baijiazheng/JB-Micro-Wheeled_leg-Robot/docs/board_spec.md

# 板级规格书（四板统一定义）

> 定稿 2026-09-13 ｜ 修订 2026-09-14（编码器/IMU 改卫星板、补板间连接器）
>
> 全车 **4 块 PCB**：驱动板 F103 (50×50)、主控板 F407 (50×50)、编码器板 ×2 (12×12)、IMU 板 ×1 (12×12)。
> 两块大板同尺寸、同孔位 → 可堆叠 → 即插即用。

---

## 一、机械规格

### 1.1 两块大板（统一定义）

| 项 | 值 | 说明 |
|---|---|---|
| **外形尺寸** | **50 × 50 mm** | 两板统一，圆角 R2 |
| 层数 | 2 层 | 顶层信号 + 底层整片 GND |
| 板厚 | 1.6 mm | 嘉立创标准 |
| 铜厚 | 1 oz（电机轨可 2 oz） | |
| 安装孔 | **4× M2.5**，坐标 (3,3)(47,3)(3,47)(47,47) | 原点取板左下角 |
| 堆叠 | 驱动板在下、主控板在上，M2.5 铜柱 8mm | 见"五、堆叠" |

**尺寸依据**：驱动板 45 个元件封装占用 ≈ 940 mm²（其中 2× L6234 占 352 mm²），
主控板 30 个元件 ≈ 620 mm²；50×50 = 2500 mm² → 密度 38% / 25%，布线空间充裕。

### 1.2 三块卫星板

| 板 | 尺寸建议 | 元件数 | 说明 |
|---|---|---|---|
| 编码器板 ×2 | 12 × 12 mm | 6 | AS5600 正对电机轴端磁铁，**必须现场定位** |
| IMU 板 ×1 | 12 × 12 mm | 6 | 放整车重心投影点，远离电机热源 |

**三块小板的摆放位置由机械决定，所以做成卫星板。** 打样时它们和两块大板**拼在同一张 50×50
里**（V-CUT 或邮票孔），掰开即用，成本几乎为零。

---

## 二、功能分区（坐标原点 = 板左下角）

### 2.1 驱动板 F103（45 元件）

```
(0,50)                                                  (50,50)
  ┌──────────────────────────────────────────────────┐
  │ ○(3,47)                                  (47,47)○│
  │  ┌── 电源区 (x5~20, y34~47) ──┐ ┌─ 通信区 (x30~47, y34~47) ─┐
  │  │ J1 电池  SW1  D1           │ │ U9 TJA1050  R8 120Ω      │
  │  │ U7 MP2225  L1  U8 AMS1117  │ │ U10 CH340C  J5 USB  C22   │
  │  │ C1~C4  C23 C24  R1 R2 R3   │ │ J4 SWD  J7(→IMU 板)      │
  │  └────────────────────────────┘ └──────────────────────────┘
  │         ┌──── MCU 区 (x13~37, y18~32) ────┐
  │         │  U1 LQFP-48                     │
  │         │  R9 BOOT0  R10/C19 NRST  C25 去耦│
  │         │  R12/R13 电池分压 (100k/47k)     │
  │         └─────────────────────────────────┘
  │        J6(→编码器①)      J8 板间 2×4      │
  │  ┌─ 电机1 (x2~20,y2~15) ─┐  ┌─ 电机2 (x30~48,y2~15) ─┐
  │  │ U2 L6234  C5 C6       │  │ U3 L6234  C7 C8       │
  │  │ C13 C14 C15           │  │ C16 C17 C18           │
  │  │ J2 电机1 3P           │  │ J3 电机2 3P           │
  │  └───────────────────────┘  └───────────────────────┘
  │ ○(3,3)                          D2 LED  (47,3)○    │
  └──────────────────────────────────────────────────┘
(0,0)                                                  (50,0)
```

### 2.2 主控板 F407（30 元件）

```
(0,50)                                                  (50,50)
  ┌──────────────────────────────────────────────────┐
  │ ○(3,47)                                  (47,47)○│
  │  ┌── 电源区 (x5~20, y34~47) ──┐ ┌─ 通信区 (x30~47, y34~47) ─┐
  │  │ J1 电池  SW1  D1           │ │ U2 TJA1050  R4 120Ω      │
  │  │ U5 MP2225  L1  U4 AMS1117  │ │ U3 CH340C  J5 USB  C9    │
  │  │ C1~C4  C6 C7  R1 R2 R3     │ │ J4 SWD  R6 D2 LED        │
  │  └────────────────────────────┘ └──────────────────────────┘
  │         ┌──── MCU 区 (x13~37, y18~32) ────┐
  │         │  U1 LQFP-100                    │
  │         │  R7/C8 NRST  R5 BOOT0  C5 去耦  │
  │         └─────────────────────────────────┘
  │         J2 舵机总线 3P      J3 板间 2×4    │
  │ ○(3,3)                                  (47,3)○   │
  └──────────────────────────────────────────────────┘
(0,0)                                                  (50,0)
```

### 2.3 卫星板

```
编码器板 (12×12)              IMU 板 (12×12)
 ┌───────────────┐             ┌───────────────┐
 │ J2 GH1.25 4P  │             │ J1 进  J2 出  │
 │ U1 AS5600     │             │ U1 MPU6050    │
 │ R1 R2 4.7k上拉│             │ C1 C2 C3      │
 │ C1 C2         │             │               │
 └───────────────┘             └───────────────┘
  AS5600 芯片中心必须正对磁铁   两个 GH 座串联，串在编码器②线上
```

---

## 三、硬约束（违反则板子废）

| # | 约束 | 原因 |
|---|---|---|
| 1 | **AS5600 与磁铁轴向间距 0.5~3 mm，中心对齐** | 磁编码器测轴端磁场，偏了就测不准 |
| 2 | **IMU 板放整车重心投影点** | 否则平衡算法读数有系统性偏差 |
| 3 | **J6/J7/U1 的 I²C 走线短、不跨分割地** | I²C 是开漏弱上拉，干扰敏感 |
| 4 | **L6234 (U2/U3) 靠板边**，散热焊盘(EP)大铺铜 + 过孔 | 线性驱动发热 |
| 5 | **U1 每个电源脚旁 0.1uF 紧贴** | 去耦 |
| 6 | **电机轨（VIN→L6234 Vs）加粗 ≥1mm** | 电机电流 |
| 7 | **底层整片铺 GND**，不割断 | 完整地平面 |
| 8 | **MP2225 功率回路（U7/L1/C1/C3）面积最小** | 开关电源环路是 EMI 和纹波的根源 |
| 9 | **板间 J8/J3 丝印必须标脚 1** | 插反烧两板 |

---

## 四、焊接约束（锡膏 + 加热台 + 钢网）★

**加热台一次只能焊一面**（背面元件会被压住/位移），所以：

- ✅ **所有 SMD 放同一面**（统一放**顶层**）
- ✅ 插件元件（J1~J5 排针、SW1 开关、USB）放**底层**，或顶层最后手焊
- ✅ 一次回流焊完成所有 SMD → 再手焊插件

**必须买钢网**：手点锡膏焊 0.5 mm 间距（LQFP-100 / QFN-24）基本必连锡，钢网 ¥30~60。

**交给嘉立创 SMT 贴的 5 个难焊件**（路线 C）：

| 板 | 位号 | 器件 | 封装 | 难点 |
|---|---|---|---|---|
| 主控板 | U1 | STM32F407VET6 | LQFP-100 | 100 脚 / 0.5 mm |
| 驱动板 | U1 | STM32F103C8T6 | LQFP-48 | 48 脚 / 0.5 mm |
| 驱动板 | U2/U3 | L6234 | PowerSO-20 | 底部散热焊盘 |
| IMU 板 | U1 | MPU6050 | QFN-24 | 底部散热焊盘 / 0.5 mm |

其余（0805 阻容、SOT-223、SOIC-8、SOP-16、TSOT-23-8）加热台自焊。

---

## 五、堆叠（即插即用）

```
        ┌──────────────┐
        │  主控板 F407  │  ← 上层（母座 2×4）
        └──────────────┘
           ↓ ↓ ↓ ↓         2×4 排针（公头在驱动板上）
        M2.5 铜柱 ×4 (8mm)
           ↓ ↓ ↓ ↓
        ┌──────────────┐
        │  驱动板 F103  │  ← 下层（贴电机，唯一电源入口）
        └──────────────┘
```

### 板间 2×4 排针脚位定义（★ 两板必须一致）

| 脚 | 信号 | 脚 | 信号 |
|---|---|---|---|
| **1** | VIN (7.4V) | **2** | VIN |
| **3** | GND | **4** | GND |
| **5** | CAN_H | **6** | CAN_L |
| **7** | GND | **8** | GND |

**设计要点**：

- 电源 2 脚并联、地 4 脚并联 → 扛舵机瞬时大电流
- CAN_H / CAN_L 是相邻的 5、6 脚，上下都是地 → 差分信号质量最好
- **VIN 从驱动板上供**：车上只有一个电池口、一个开关（驱动板 SW1）
- 主控板的 J1/SW1/D1 保留，但**只用于单独调试主控板**；堆叠时主控板 SW1 保持关闭
- 两板 50×50、四角孔位一致 → 随时拆装、换板不换机械

> 自动校验：`python3 hardware/check_netlists.py` 会逐脚核对 J8↔J3 一致性。

---

## 六、卫星板接口（GH1.25 4PIN 统一线序）

**全车 3 根 GH1.25 4PIN 双头线，线序完全统一**（否则插错直接烧芯片）：

| 脚 | 信号 | 建议线色 |
|---|---|---|
| **1** | +3V3 | 红 |
| **2** | SCL | 蓝 |
| **3** | SDA | 绿 |
| **4** | GND | 黑 |

### I²C 拓扑

```
驱动板 U1 ── I²C1 (PB6/PB7) ──► J6 ──(GH1.25)──► 编码器板①
驱动板 U1 ── I²C2 (PB10/PB11) ─► J7 ──(GH1.25)──► IMU 板 J1
                                                    IMU 板 J2 ──(GH1.25)──► 编码器板②
```

- 两块 AS5600 地址**出厂固定 0x36 不可改** → 必须分两条总线
- I²C 上拉（4.7k）**只放编码器板上**，IMU 板不装，避免并联后阻值减半
- IMU 板串在线上，于是"IMU 和右编码器共用 I²C2"（与参考项目一致）

---

## 七、布线规则

| 规则 | 值 |
|---|---|
| 最小线宽/间距 | 6 mil / 6 mil |
| 电源线 | ≥ 0.5 mm |
| 电机轨 | ≥ 1.0 mm |
| 板间 VIN/GND | ≥ 1.0 mm（就在排针旁，越短越粗） |
| CAN 差分对（CAN_H/CAN_L） | 并排走，间距恒定，尽量短 |
| L6234 三相 PWM | 短、粗（≥0.3 mm），三根尽量等长 |
| 铺铜 | 底层 GND 整片；顶层可局部铺 |
| 过孔 | 0.3/0.6 mm（散热焊盘多打过孔） |

### 摆放优先级（按这个顺序调）

1. U1 去耦电容 → 紧贴 VDD/VSS 脚
2. L6234 (U2/U3) → 靠板边 + 散热焊盘下大铺铜 + 多打过孔
3. MP2225 功率回路（U7/L1/C1/C3）→ 环路面积最小
4. 电机轨 VIN→L6234 Vs → ≥1 mm
5. CAN 差分（U9 ↔ J8/J3）→ 并排等距
6. 晶振/复位/BOOT → 靠近 MCU
7. 最后摆连接器（J1~J8）到板边

---

## 八、打样参数（嘉立创下单）

| 项 | 值 |
|---|---|
| 层数 | 2 |
| 尺寸 | 50 × 50 mm ×2 块 + 卫星板拼板 |
| 板厚 | 1.6 mm |
| 表面处理 | **沉金 ENIG**（QFN 焊接更可靠，卫星板间距小更需要） |
| 数量 | 5 片 |
| SMT 贴片 | **部分贴片**：只贴第四节列出的 5 个难焊件，其余标"不贴" |
| 钢网 | **必须下单**（激光钢网，¥30~60） |

---

## 九、相关文档

| 文件 | 内容 |
|---|---|
| `docs/wiring/接线示意图.html` | **小白接线图**（分享给别人的那份） |
| `docs/bom.md` | BOM 与采购清单（含渠道、避坑、下单顺序） |
| `docs/schematic_design.md` | 原理图设计说明 |
| `docs/pcb_layout.md` | PCB 布局布线 |
| `docs/bringup_plan.md` | 上电联调步骤 |
| `hardware/check_netlists.py` | 四板网表 + 板间连接自动校验 |
