baijiazheng/JB-Micro-Wheeled_leg-Robot/docs/bom.md

# BOM 与采购清单

> 定稿 2026-09-13 ｜ 修订 2026-09-14
>
> 全车 **4 块 PCB / 93 个元件**（驱动板 45 + 主控板 30 + 编码器板 6×2 + IMU 板 6）。
> 采购分**三个渠道**，走错渠道要么买不到、要么买到假货。

---

## 〇、先做决定：焊接路线

| 路线 | 做法 | 大致成本 | 手焊风险 |
|---|---|---|---|
| A 全自己焊 | 立创商城买料 + 钢网 + 加热台 | 料费 ≈ ¥200 | 高 |
| B 全托管 | 嘉立创 SMT 代购 + 贴片 | ≈ ¥600+ | 无 |
| **C 折中 ★ 已选定** | 自己买料，嘉立创只贴 5 个难焊的 | ≈ ¥350 | 低 |

**路线 C 只让嘉立创贴这 5 个**（其余 0805 阻容 / SOT-223 / SOIC-8 / SOP-16 用加热台自焊）：

| 板 | 位号 | 器件 | 封装 | 难点 |
|---|---|---|---|---|
| 主控板 | U1 | STM32F407VET6 | LQFP-100 | 100 脚 / 0.5 mm |
| 驱动板 | U1 | STM32F103C8T6 | LQFP-48 | 48 脚 / 0.5 mm |
| 驱动板 | U2 / U3 | L6234PD013TR | PowerSO-20 | 底部散热焊盘 |
| IMU 板 | U1 | MPU6050 | QFN-24 | 底部散热焊盘 / 0.5 mm |

> **钢网必须买**（嘉立创激光钢网 ¥30~60）。手点锡膏焊 0.5 mm 间距基本必连锡，
> 有钢网 + 加热台，剩下的 88 个元件都不难。

---

## 一、渠道分工

| 渠道 | 买什么 | 为什么 |
|---|---|---|
| **立创商城** | 全部电子元器件、PCB 打样、SMT、钢网 | LCSC 料号与嘉立创同源；假货风险最低 |
| **淘宝** | 电机、舵机、电池、轮胎、轴承、磁铁、螺丝、GH1.25 线 | 立创商城没有这些 |
| **自己加工** | 3D 打印 + CNC + 碳纤板 | 按参考项目 STP 文件 |

---

## 二、立创商城（电子料）

### 2.1 下单流程

1. 立创EDA专业版 → **封装管理器（必须切「在线模式」）** → 给每个元件绑定**商城元件**（带 `C` 编号）
2. 导出 BOM（[官方文档](https://docs.easyeda.com/cn/Schematic/Export-BOM/index.html)）
3. **一键配单 → 加入购物车**（[下单流程](https://docs.lceda.cn/cn/PCB/Order-PCB/index.html)）
4. PCB 打样时勾选 **SMT 部分贴片**，把第一节那 5 个难焊件标记为「贴」，其余标「不贴」
5. 同一单里加 **激光钢网**

### 2.2 避坑表（★ 这几个器件假货/翻新很多）

参考项目的原始 BOM 里有真实原厂料号，直接照抄搜索最稳。原始文件在
`~/Micro-Wheeled_leg-Robot/2.Hardware/*/BOM_*.csv`（**UTF-16 编码**，编辑器里手动选 UTF-16 才能正常显示）。

| 器件 | 原厂料号 / 厂商 | 坑 |
|---|---|---|
| **L6234PD013TR** | STMicroelectronics | ⚠️ **参考项目 README 原文警告：淘宝假货极多** |
| **MPU6050** | InvenSense / TDK | ⚠️ **已停产**，市面多为翻新；买 3 个备件 |
| **AS5600-ASOM** | Ams (ams-OSRAM) | 国产替代混卖，认准 ams |
| **AMS1117-3.3** | Youtai Semiconductor | 假货多，认准原厂标 |
| MP2225GJ-Z | MPS | |
| CH340C | WCH 南京沁恒 | 无假货，放心 |
| TJA1051T（替代 TJA1050） | TI / NXP | 可换 SIT1042（国产便宜）或 SN65HVD230 |
| 4.7uH 电感 | PSA `MCS0630-4R7MPY1` | |
| 22uF / 10uF / 1uF 0805 | Samsung `CL21A106KOQNNNE` 等 | |
| 220nF / 100nF 0805 | Samsung / HEC / YAGEO | |
| 100uF 钽电容 | AVX `TAJD107M020RNJ` | |
| LED 红/蓝 0805 | EVERLIGHT / 光华 ARKLED | |
| SS-12D02-VG4 开关 | Rectangular Connectors | |
| GH1.25 4P 座 | 长江连接器 | |
| 排针 1×3 / 1×4 / 2×4 | 普通 2.54 排针 | |

**建议多买 1 个备件**：L6234 ×3、AS5600 ×3、MPU6050 ×3、STM32F103 ×2、STM32F407 ×2。

### 2.3 被动元件合并清单（4 块板合计）

| 器件 | 值 | 总数量 | 分布 |
|---|---|---|---|
| 电阻 0805 | 100k | 3 | 驱动 R1,R12 / 主控 R1 |
| 电阻 0805 | 47k | 1 | 驱动 R13（电池分压） |
| 电阻 0805 | 40.2k | 2 | MP2225 反馈 |
| 电阻 0805 | 5.49k | 2 | MP2225 反馈 |
| 电阻 0805 | 10k | 4 | NRST 上拉 / BOOT0 下拉 |
| 电阻 0805 | 4.7k | 4 | 编码器板 I²C 上拉（2 板 × 2） |
| 电阻 0805 | 1k | 2 | LED 限流 |
| 电阻 0805 | 120Ω | 2 | CAN 终端（两块大板各 1） |
| 电容 0805 | 22uF | 4 | MP2225 输入/输出 |
| 电容 0805 | 1uF | 4 | |
| 电容 0805 | 0.1uF | 6 | |
| 电容 0805 | 100nF | 9 | 去耦 + 编码器 + IMU |
| 电容 0805 | 220nF | 2 | L6234 Vcp |
| 电容 0805 | 10nF | 4 | L6234 Vref / CH340C V3 |
| 电容 0805 | 2.2nF | 1 | MPU6050 CPOUT（**注意是 nF 不是 uF**） |
| 电容 钽/电解 | 100uF | 1 | L6234 电机轨旁路 |

> **建议 0805 阻容按 100 个一盘买**（¥1~2/盘），比按个买便宜且备损。
> 优先选**立创商城基础库**元件，SMT 时免上料费。

---

## 三、淘宝（机电机械）

参考项目原始采购清单：`~/Micro-Wheeled_leg-Robot/1.RobotModel/Parts-Purchased/BOM.xlsx`

| 名称 | 规格 | 数量 | 备注 |
|---|---|---|---|
| 轮子电机 | 参考淘宝 id `556445606114` | 2 | 小无刷外转子，转速常数要配对 |
| 腿部舵机 | FEETECH **STS3032** / 360° 黑色 | 2 | 认准官方店，假货/翻新多 |
| 磁铁 | **直径 4mm × 厚 1mm** | 2 | 502 胶粘电机转轴端面 |
| 电池 | 2S 锂电 1100mAh（XH2.54 插头） | 2 | 7.4V；买 2 块方便轮换 |
| 平衡充电器 | 2S 平衡充 | 1 | |
| 轮胎 | 直径 25mm × 宽 10mm | 2 | |
| **GH1.25 4PIN 双头线** | **15cm** | **3** | ★ 卫星板必需，参考项目明确列出 |
| 轴承 | 3×6×2（×4）、4×7×2.5（×4） | — | |
| 螺丝/铜柱 | M2 系列 + **M2.5 铜柱 8mm ×4** | 若干 | 铜柱用于板间堆叠 |
| 机械件 | 3D 打印（尼龙粉末烧结）+ CNC + 碳纤板 | 按参考 STP | 见 `1.RobotModel` |

> ⚠️ **电池正负极**：参考项目 README 特别提醒，非原厂电池的 XH2.54 插头正负极可能相反，
> 插之前一定用万用表量一下，插反直接烧板。

---

## 四、嘉立创（PCB + SMT + 钢网）

| 项 | 值 |
|---|---|
| 层数 / 尺寸 / 厚度 | 2 层 ｜ 50×50 mm ×2 + 卫星板拼板 ｜ 1.6 mm |
| 表面处理 | **沉金 ENIG**（QFN 焊接更可靠） |
| 数量 | 5 片 |
| SMT | **部分贴片**，只贴 5 个难焊件 |
| 钢网 | **必须下单** |

打样参数详见 `docs/board_spec.md` 第八节。

---

## 五、下单顺序（★ 别搞反）

1. **第一批（立刻下，货期长）**
   - 淘宝：电机、舵机（货期最长，先锁单）、电池、磁铁、GH1.25 线
   - 参考项目 `BOM.xlsx` 里的机械件（3D 打印/CNC 周期更长）

2. **第二批（等原理图封装绑定完成）**
   - 立创商城：按 BOM 一键配单买全部电子料 + 钢网
   - 嘉立创：PCB 打样 + SMT 部分贴片

3. **第三批（板子到手、先焊卫星板练手）**
   - 先用卫星板（12×12，好焊）和加热台练回流焊手感
   - 卫星板焊废了不心疼，练熟了再焊两块大板

> **为什么第三批这么安排**：加热台 + 钢网的手感需要练。
> 卫星板一共才 6 个元件、成本几块钱，是最好的练手板；
> 两块大板上的 LQFP-100 才是真正要小心的地方（而且那 5 个已经交给嘉立创了）。

---

## 六、四块板元件总表（按板）

### 驱动板 F103（45 元件）

| 类别 | 器件 |
|---|---|
| 主控 | U1 STM32F103C8T6 (LQFP-48) |
| 电机驱动 | U2/U3 L6234PD013TR (PowerSO-20) |
| 电源 | U7 MP2225GJ-Z、U8 AMS1117-3.3、L1 4.7uH、D1 SS34、SW1、J1 |
| 通信 | U9 TJA1050/TJA1051T、U10 CH340C、R8 120Ω、J4 SWD、J5 USB |
| 卫星板接口 | **J6**（→编码器①）、**J7**（→IMU 板）GH1.25 4P |
| 板间堆叠 | **J8** 2×4 排针 |
| 电机输出 | J2 电机1 3P、J3 电机2 3P |
| 阻容 | R1 R2 R3 R9 R10 R11 R12 R13 C1~C6 C13~C19 C22~C25 D2 |

### 主控板 F407（30 元件）

| 类别 | 器件 |
|---|---|
| 主控 | U1 STM32F407VET6 (LQFP-100) |
| 电源 | U5 MP2225GJ-Z、U4 AMS1117-3.3、L1 4.7uH、D1 SS34、SW1、J1 |
| 通信 | U2 TJA1050/TJA1051T、U3 CH340C、R4 120Ω、J4 SWD、J5 USB |
| 板间堆叠 | **J3** 2×4 排针 |
| 舵机 | J2 舵机总线 3P（STS3032 可串接） |
| 阻容 | R1 R2 R3 R5 R6 R7 C1~C9 D2 |

### 编码器板（6 元件 ×2 块）

`U1` AS5600-ASOM (SOIC-8) ｜ `J2` GH1.25 4P ｜ `R1 R2` 4.7k 上拉 ｜ `C1` 100nF ｜ `C2` 1uF

### IMU 板（6 元件 ×1 块）

`U1` MPU6050 (QFN-24) ｜ `J1 J2` GH1.25 4P（进/出） ｜ `C1` 100nF ｜ `C2` 2.2nF ｜ `C3` 100nF

---

## 七、关键风险提示

- ⚠️ **L6234 假芯片极多**（参考项目作者原文警告）→ 立创商城自营/原厂渠道，多买 1 个
- ⚠️ **MPU6050 已停产**，市面多为翻新 → 立创商城现货，买 3 个
- ⚠️ **AS5600 地址固定 0x36 不可改** → 两块必须分两条 I²C 总线（F103 正好 2 个）
- ⚠️ **F103 20KB RAM 偏紧**：FOC×2 + 平衡 + I²C，实测 text 27KB / bss 788B，够用；
  若后续加功能不够 → 升级 F303CC（40KB RAM，也有 CAN，LQFP-48 引脚兼容）
- ⚠️ **MPU6050 的 CPOUT 电容是 2.2nF 不是 2.2uF** —— 看错一位平衡环会有噪声
- ⚠️ **所有板必须共地**，GH1.25 线序全车统一：`1=+3V3 2=SCL 3=SDA 4=GND`

---

## 八、相关文档

| 文件 | 内容 |
|---|---|
| `docs/wiring/接线示意图.html` | **小白接线图**（分享给别人的那份） |
| `docs/board_spec.md` | 板级规格书（尺寸、分区、堆叠、布线规则、打样参数） |
| `docs/bringup_plan.md` | 上电联调步骤 |
| `hardware/check_netlists.py` | 四板网表 + 板间连接自动校验 |
