baijiazheng/JB-Micro-Wheeled_leg-Robot/docs/wiring/接线示意图.html

# 接线示意图

JB 微轮足机器人 · STM32 双板 + CAN 版本 · 面向第一次动手的同学
照着这张图接，不会烧板子。全车一共 4 块 PCB、7 根线。

## 一、整车接线总图

电源 地线 I²C 传感器 CAN 总线 电机三相 舵机总线

## 二、接线清单（一共 7 根线）

# | 从 | 到 | 线材 | 长度

1 | 电池 XH2.54 | 驱动板 J1 | XH2.54 2P 双头 | 按车体定
2 | 驱动板 J8 | 主控板 J3 | 2×4 排针/排母（不接线，直接对插） | —
3 | 驱动板 J6 | 编码器板 ① J2 | GH1.25 4PIN 双头 | 10~15 cm
4 | 驱动板 J7 | IMU 板 J1 | GH1.25 4PIN 双头 | 10~15 cm
5 | IMU 板 J2 | 编码器板 ② J2 | GH1.25 4PIN 双头 | 10~15 cm
6 | 驱动板 J2/J3 | 左/右轮电机 | 三相硅胶线 | 尽量短
7 | 主控板 J2 | 舵机 ①→②（并联） | 3P 线，总线舵机可串接 | 按车体定

为什么传感器要做成小卫星板？
编码器的磁铁是 502 粘在电机转轴端面上的，AS5600 必须正对这块磁铁、间距 0.5~3 mm。 参考样车的底盘宽 60 mm，两轮轴线间距就是 60 mm，而主板只有 50 mm 宽 —— 芯片长在主板上的话，物理上够不到电机轴。
做成 12×12 mm 的小板贴到电机旁边，再用 GH1.25 线连回来，机械上就完全自由了。 参考项目也是这么做的（它一共 4 块 PCB）。附带好处：焊坏了只损失一小块板，不用重做主控板。

## 三、GH1.25 4PIN 线序（★ 最重要的一张表）

线色 | 脚位 | 信号 | 接错会怎样
红 | 1 | +3V3 | 和 4 脚对调 → 直接烧 AS5600 / MPU6050
蓝 | 2 | SCL | 没数据，I²C 扫描不到设备
绿 | 3 | SDA | 没数据，I²C 扫描不到设备
黑 | 4 | GND | 和 1 脚对调 → 烧芯片

防呆要点：全车 3 根 GH1.25 线完全一样，可以互换，但插之前一定要确认 线上第 1 根（红）对着插座的第 1 脚（丝印上有小三角/圆点标记）。 买线时优先买 带防呆卡扣 + 同色序 的成品线，不要自己压。

## 四、板间 2×4 排针脚位（★ 第二重要）

电源 VIN 地 GND CAN 差分

脚 | 信号 | 脚 | 信号
1 | VIN（7.4V，从驱动板上供） | 2 | VIN
3 | GND | 4 | GND
5 | CAN_H | 6 | CAN_L
7 | GND | 8 | GND

① 电源用了 2 个脚并联、地用了 4 个脚，是为了扛舵机的瞬时大电流。
② CAN_H / CAN_L 是紧挨的 5、6 脚，上下都是地 —— 这样差分信号质量最好。
③ 排针是 公头在下（驱动板）、母座在上（主控板），装反了插不进去，这就是防呆。

## 五、上电顺序（照这个顺序来，别跳步）

1

先不接电池，用万用表量短路。
量驱动板 J1 的 + 和 −，主控板 J1 的 + 和 −，都不应该是 0 Ω。 如果有短路立刻停下来找，别上电。

2

只插驱动板电池，开关先关着。
量驱动板 +5V 测试点、+3V3 测试点与 GND 之间 不能短路。

3

打开驱动板 SW1，量电压：VIN ≈ 7.4V、+5V ≈ 5.0V、+3V3 ≈ 3.3V。
偏差超过 ±5% 先别往下走。电源灯（D2 红灯）应该亮。

4

插上板间排针（把两层板扣起来），再量主控板的 +5V / +3V3。
此时主控板的 SW1 保持关着 —— 电是从排针过来的，不用开第二个开关。

5

接 ST-Link，先只烧驱动板。
SWDIO / SWCLK / GND / 3V3 四根线。烧完看能不能读到芯片 ID。

6

接 GH1.25 线，做 I²C 扫描。
应该扫到 0x36（编码器）×2 和 0x68（MPU6050）。 扫不到先查线序，不要怀疑代码。

7

最后才接电机和舵机。轮子先别装，让电机空转验证转向和编码器方向。

三条一定要记住的：

1. 两块板的 GND 必须相通（靠排针的地脚）。不共地，CAN 和 I²C 一定不工作。
2. 车上只有一个电源开关，在驱动板上。主控板的 SW1 只在你单独调试主控板时才用。
3. 首次上电不要装轮子、不要装腿，让电机空转。FOC 参数没调好之前装上去会乱窜。

## 六、四块板分别是什么

板 | 尺寸 | 核心器件 | 作用
驱动板 F103 | 50×50 | STM32F103C8T6、2× L6234、MP2225、AMS1117、TJA1050、CH340C | 跑 FOC 电机控制 + LQR 平衡，通过 CAN 收主控指令
主控板 F407 | 50×50 | STM32F407VET6、TJA1050、CH340C、MP2225、AMS1117 | 跑上层逻辑、舵机总线、CAN 主机（以后接 ESP32 网页控制）
编码器板 ×2 | 12×12 | AS5600 + 2× 4.7k 上拉 | 读电机转子绝对角度，给 FOC 用
IMU 板 ×1 | 12×12 | MPU6050 | 读车身姿态，给平衡环用。串在编码器②的线上

三块小卫星板可以拼在同一张 50×50 的板子里一起打样，掰开就能用，成本几乎为零。

## 七、I²C 拓扑（为什么 IMU 串在编码器线上）

两块 AS5600 的 I²C 地址出厂固定都是 0x36，不可改，所以必须分两条总线：

总线 | F103 引脚 | 挂的设备 | 接口
I²C1 | PB6 / PB7 | 编码器 ① | 驱动板 J6
I²C2 | PB10 / PB11 | IMU 板 → 编码器 ② | 驱动板 J7

IMU 板上有 两个 GH1.25 座（J1 进、J2 出），所以它像是"串"在线上的一节。 这样只多花一根线，就同时解决了三件事：IMU 位置自由（可以放到整车重心）、远离电机热源、少走一根线。
上拉电阻（4.7k）只放在两块编码器板上，IMU 板上不装 —— 避免并联后阻值变一半。

JB-Micro-Wheeled_leg-Robot · STM32 双板 + CAN 版 · 接线示意图
网表自检：python3 hardware/check_netlists.py —— 会核对板间排针逐脚一致性、GH1.25 线序统一性、电源开关链路完整性。
