baijiazheng/JB-Micro-Wheeled_leg-Robot/(list of files, drawings)

Other design files:
hardware/easyeda_gen/templates.json
