baijiazheng/JB-Micro-Wheeled_leg-Robot/hardware/driver_board_f103/driver_f103.kicad_sch

## KiCad design hardware/driver_board_f103/driver_f103.kicad_sch (2026-09-13)

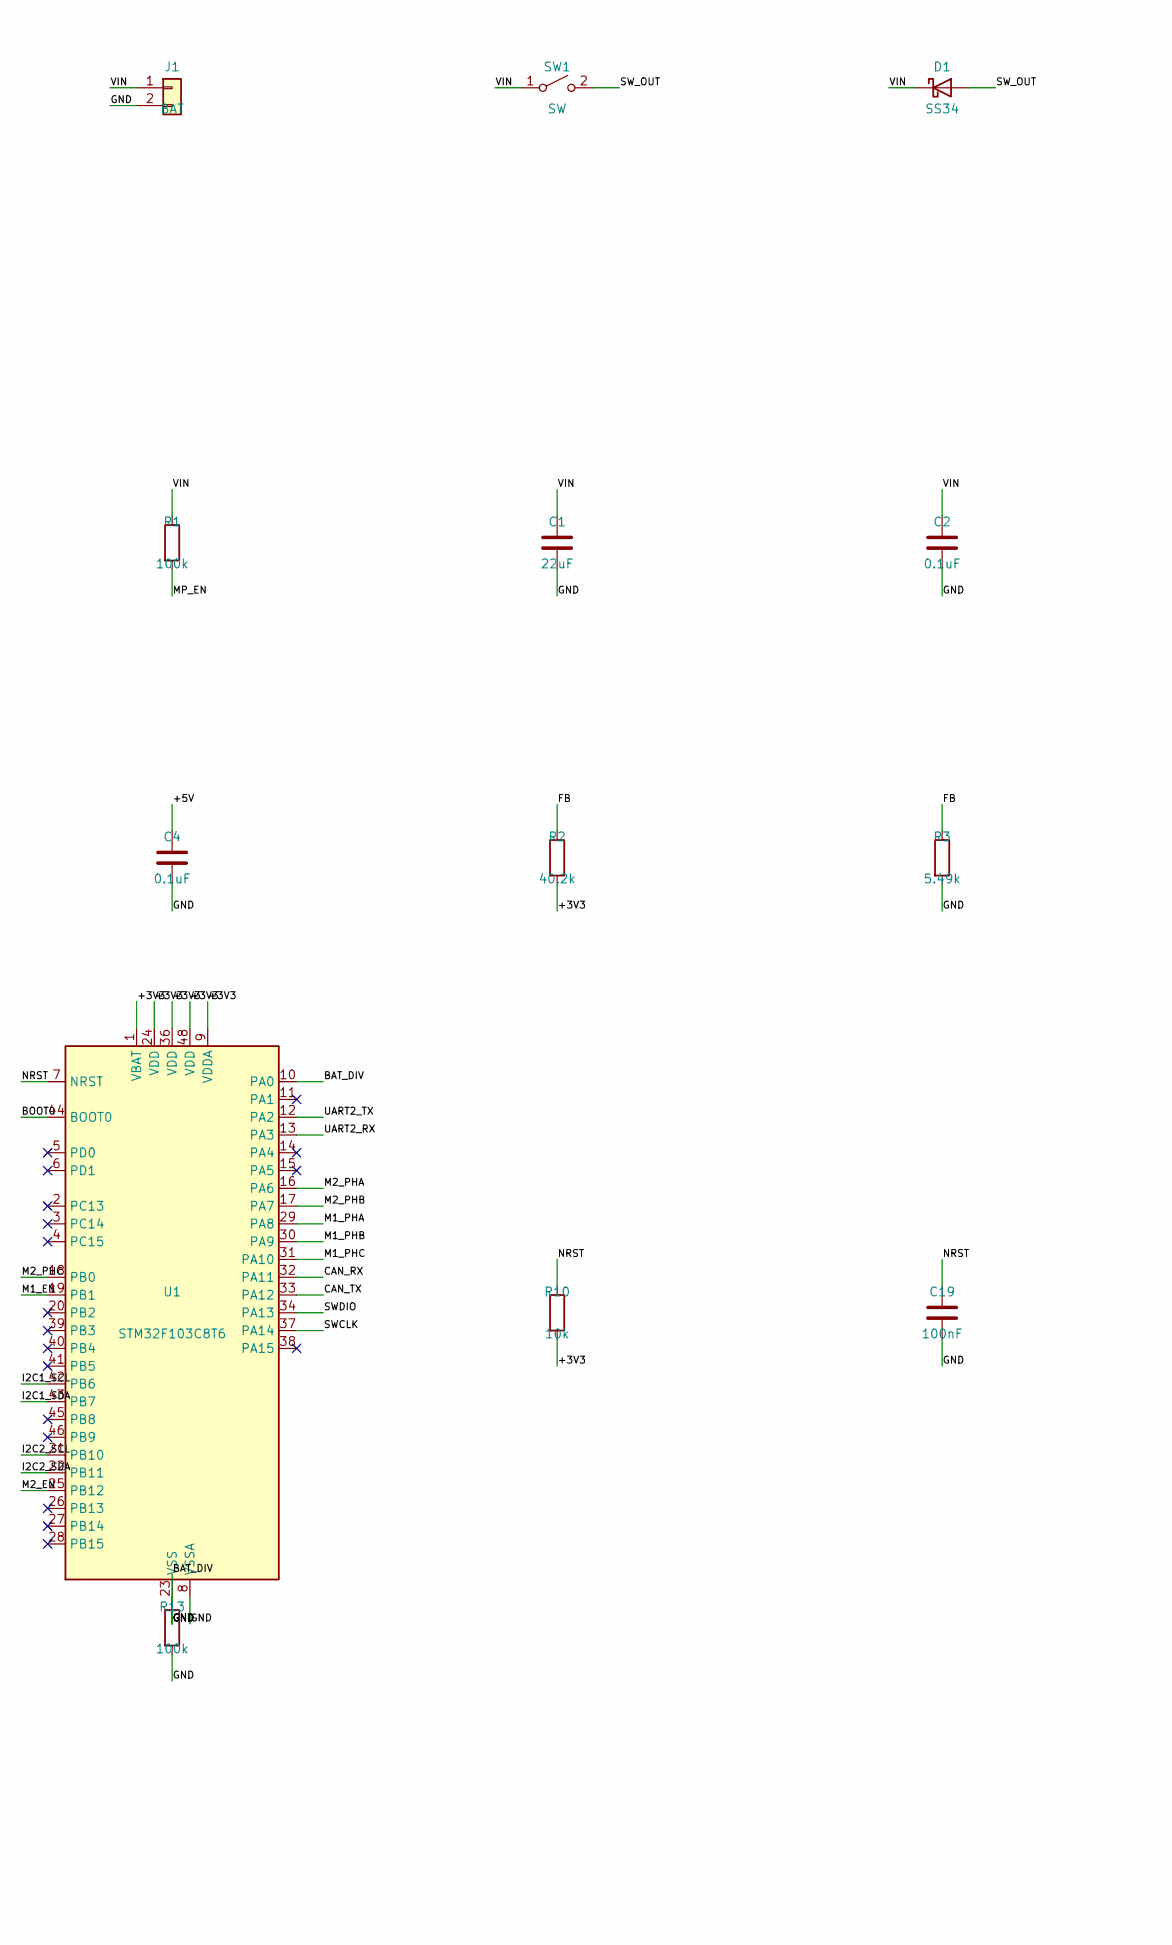
[picture p1: schematic driver_f103.kicad_sch, part in row 1, column 1]

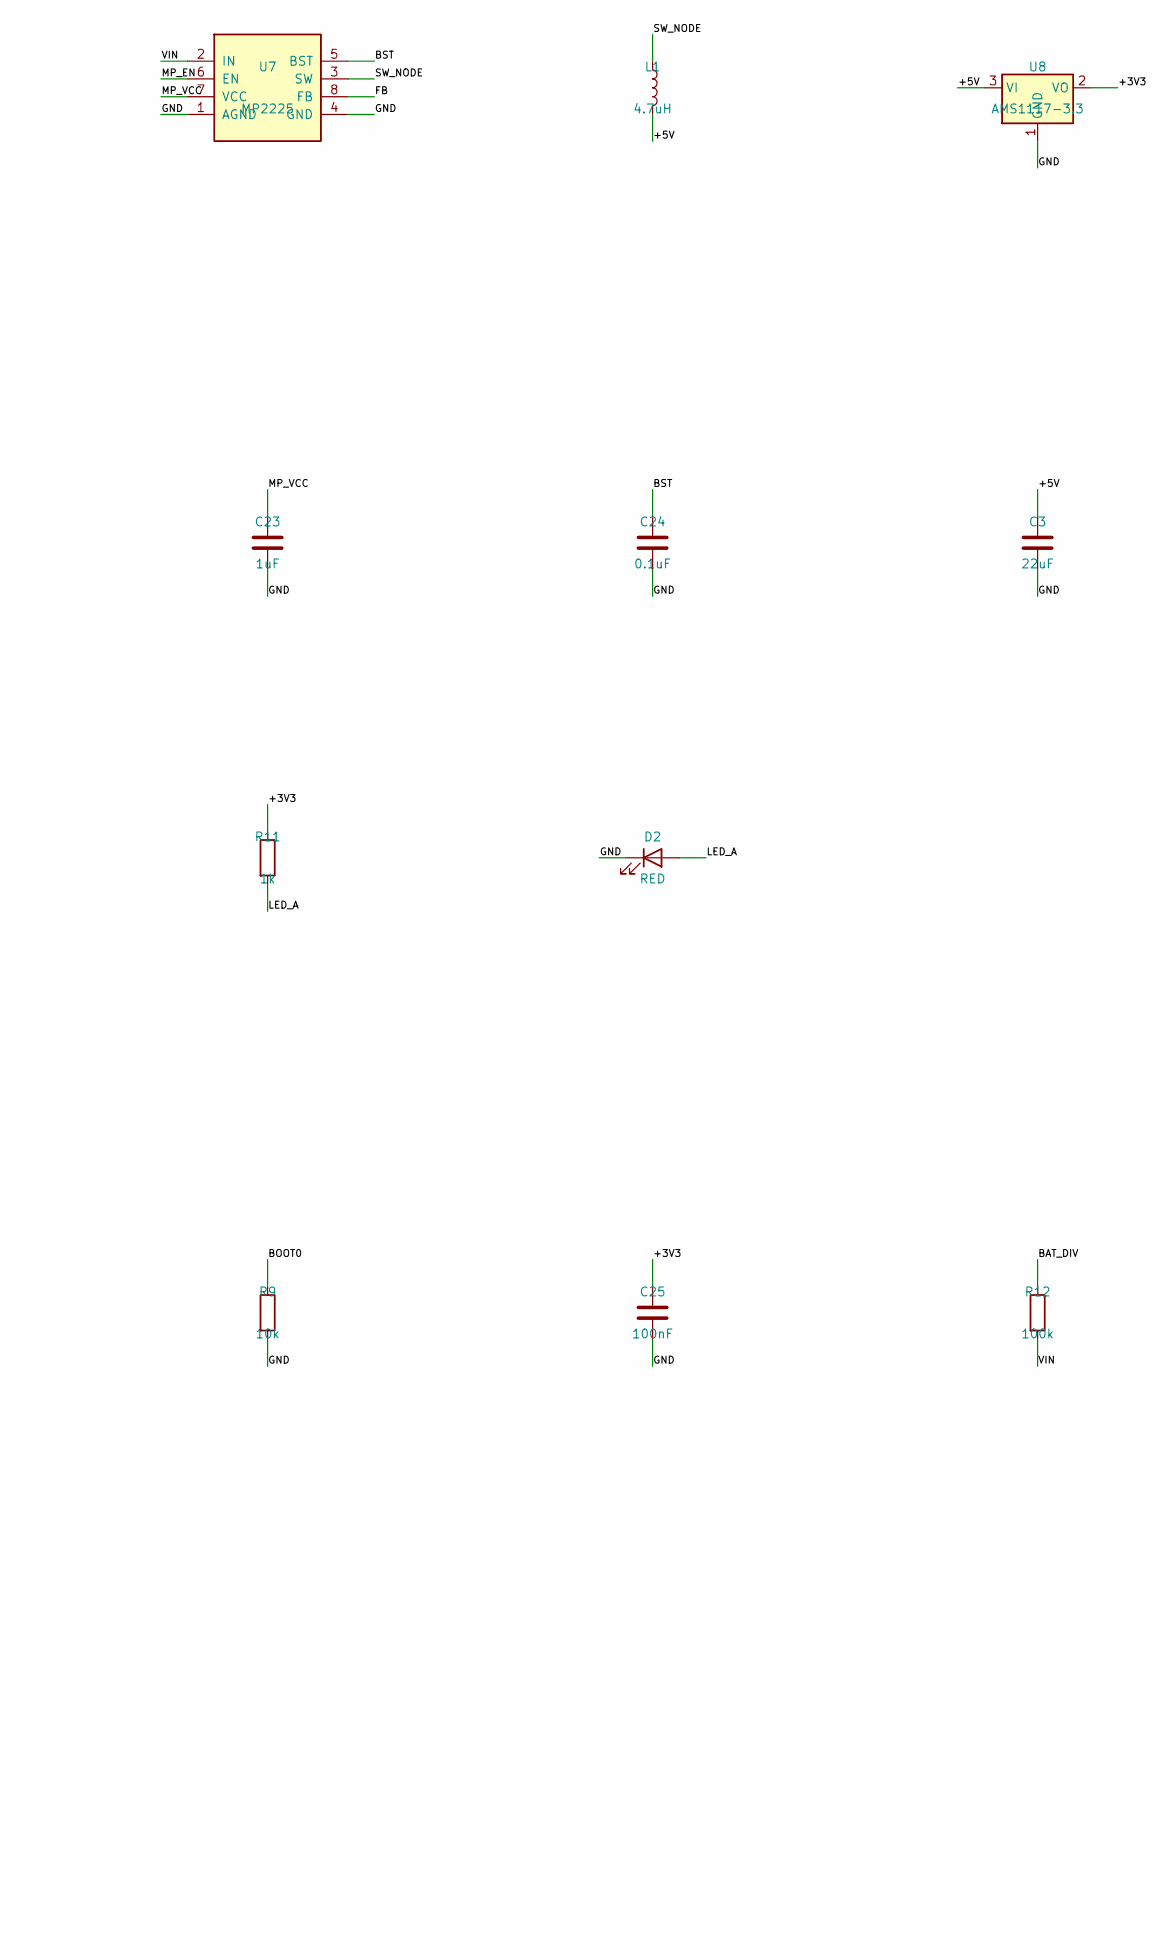
[picture p2: schematic driver_f103.kicad_sch, part in row 1, column 2]

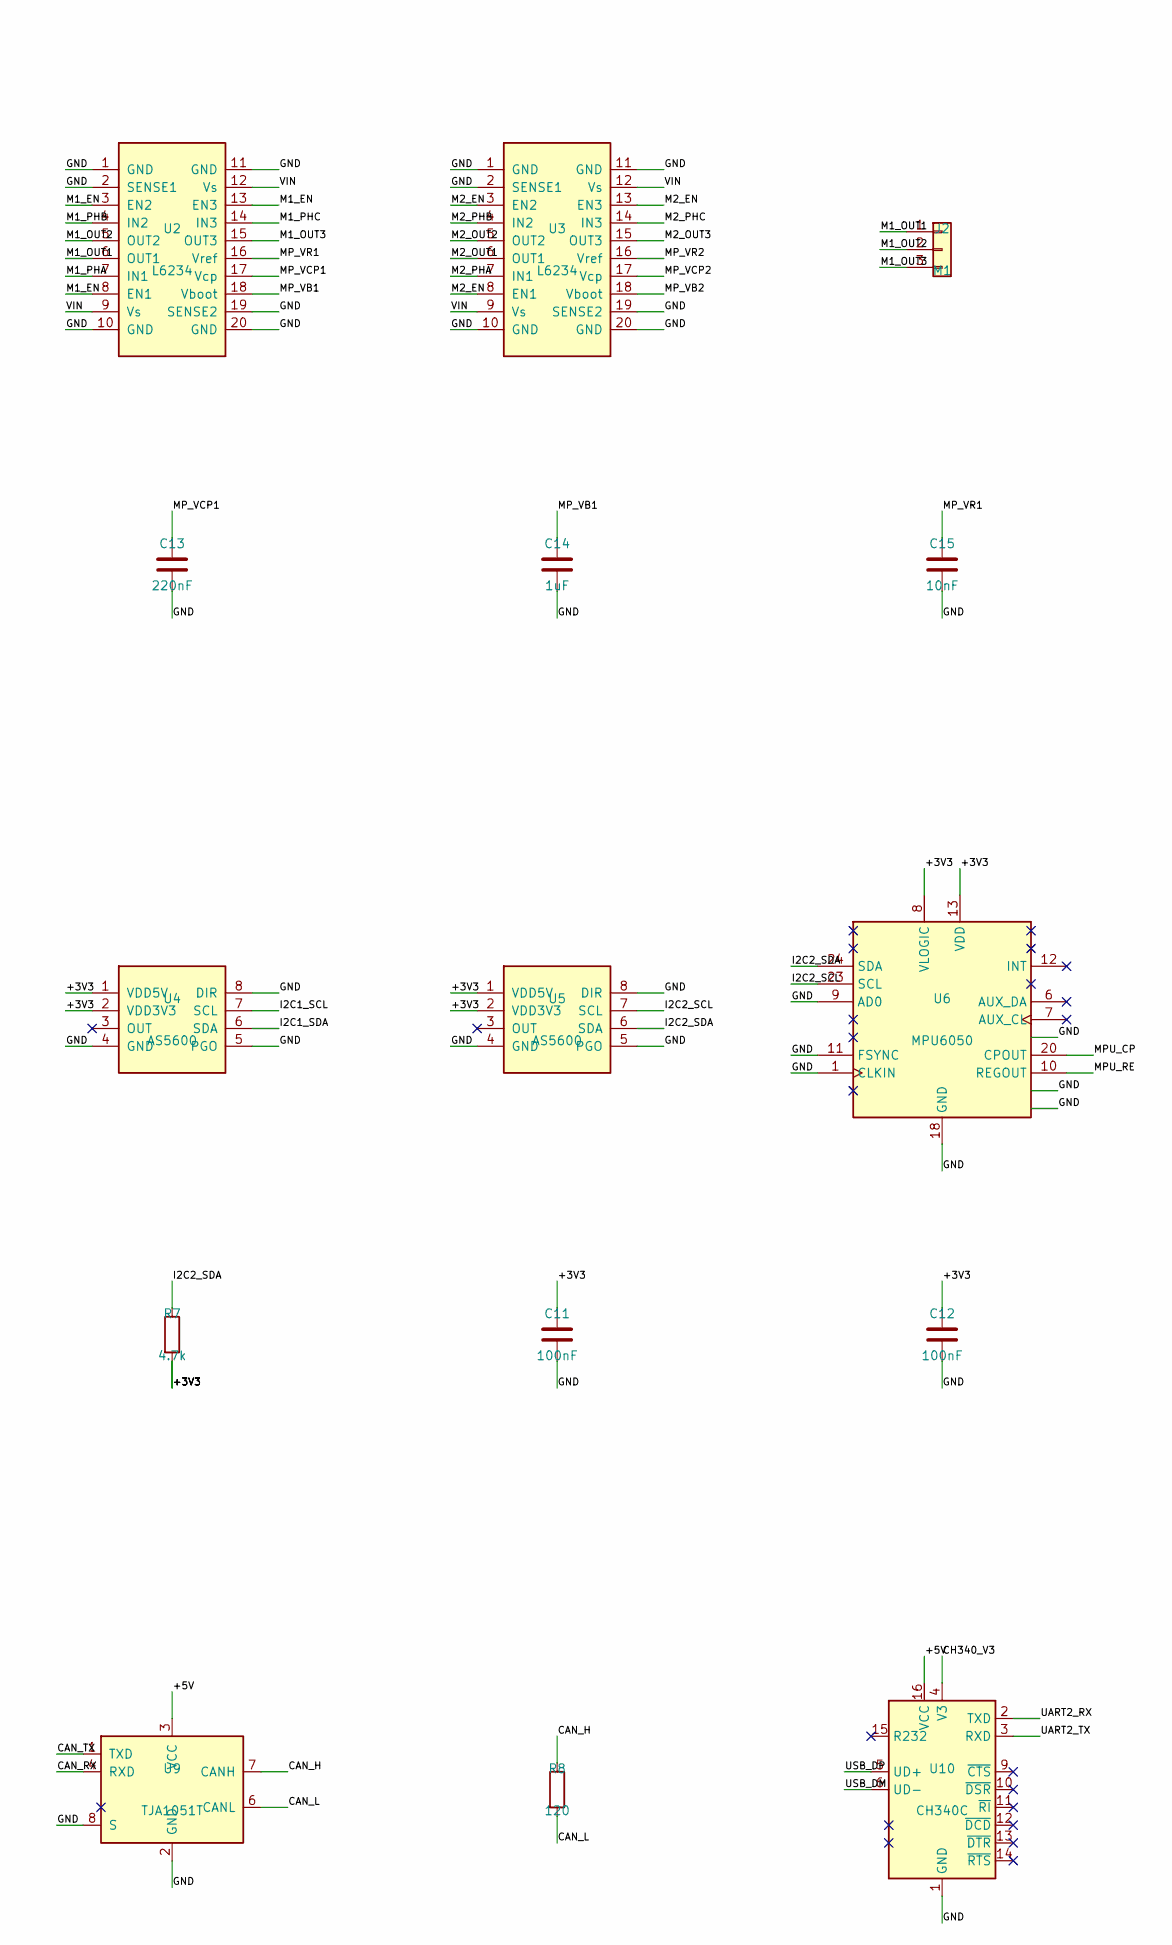
[picture p3: schematic driver_f103.kicad_sch, part in row 2, column 1]

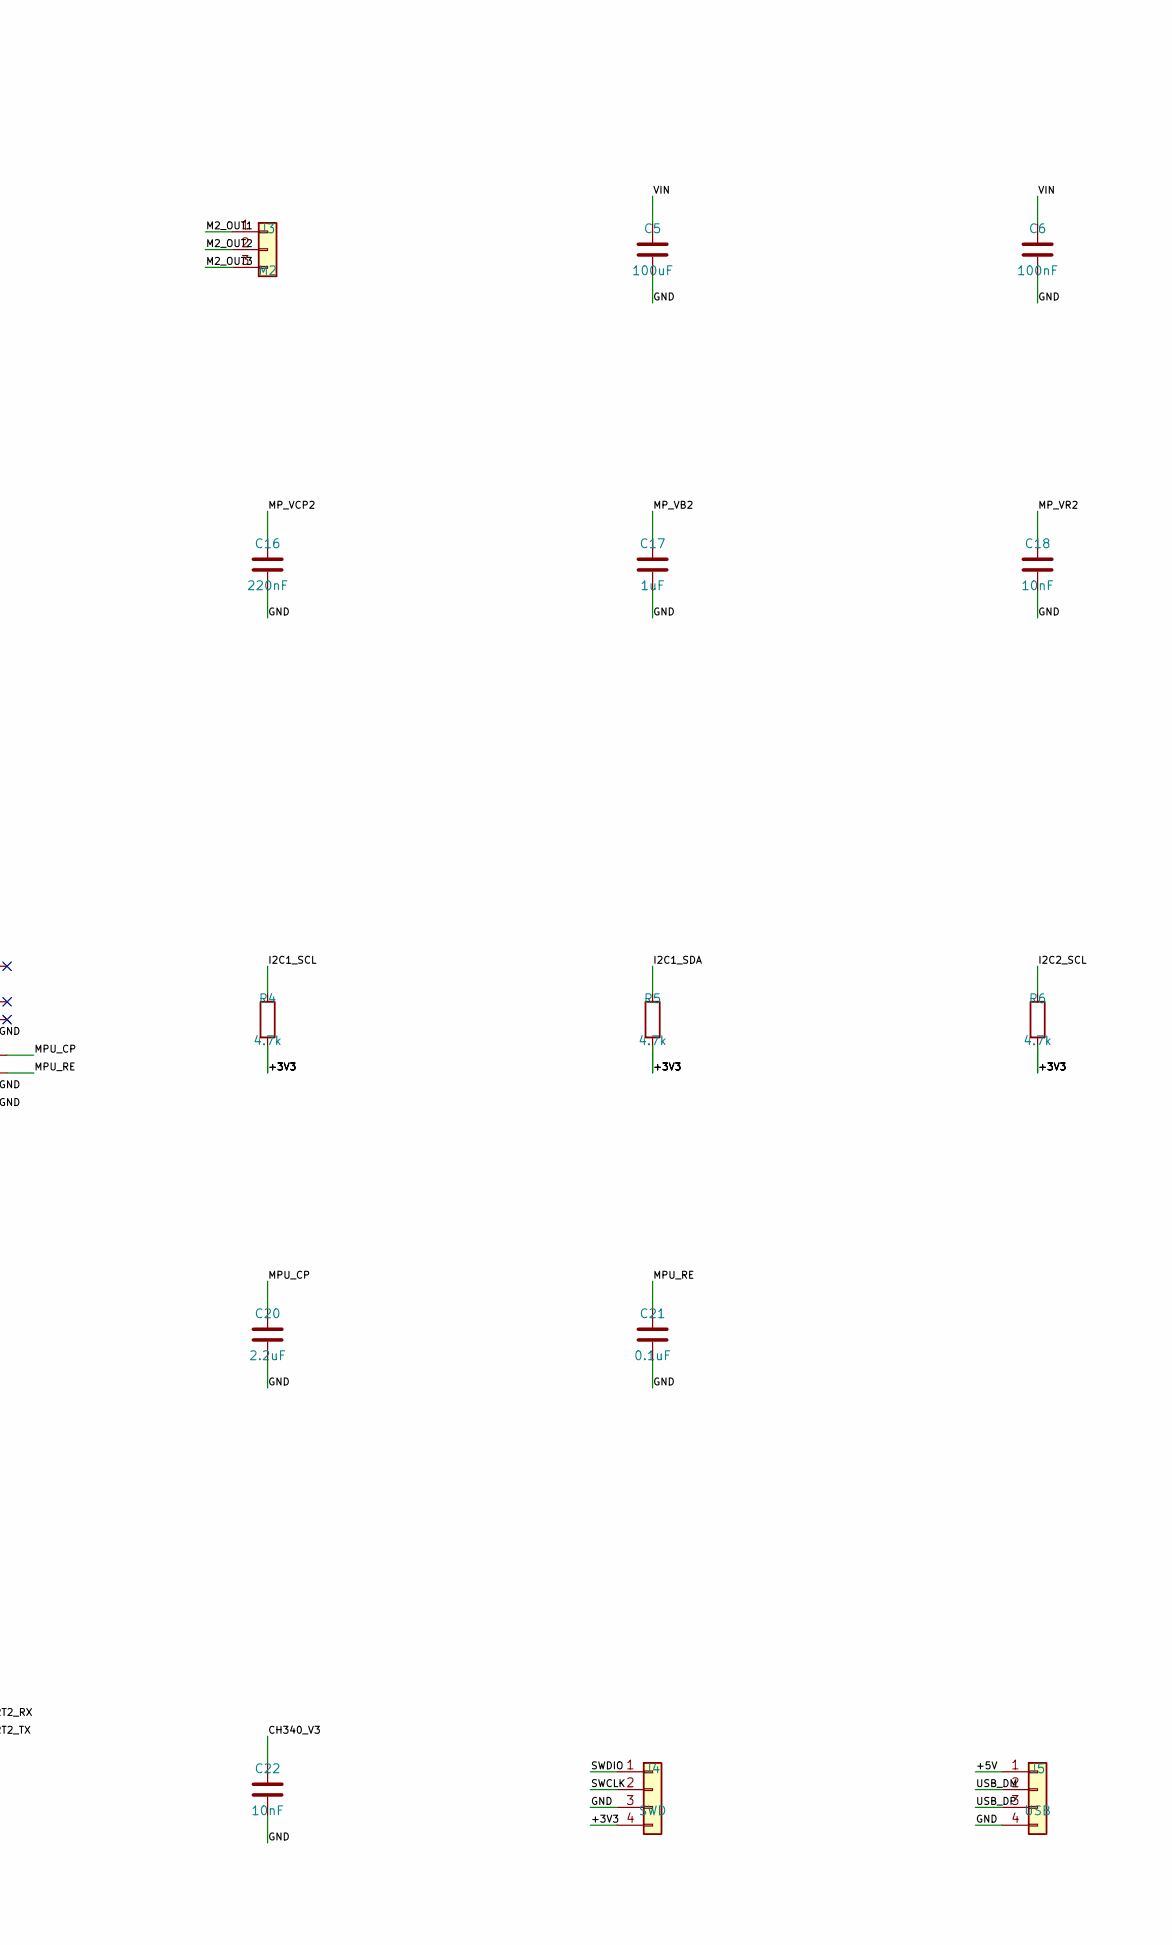
[picture p4: schematic driver_f103.kicad_sch, part in row 2, column 2]

Parts:
C1, C3: 22uF; C_0805_2012Metric
C2, C4, C21, C24: 0.1uF; C_0805_2012Metric
C5: 100uF; C_0805_2012Metric
C6, C11, C12, C19, C25: 100nF; C_0805_2012Metric
C13, C16: 220nF; C_0805_2012Metric
C14, C17, C23: 1uF; C_0805_2012Metric
C15, C18, C22: 10nF; C_0805_2012Metric
C20: 2.2uF; C_0805_2012Metric
D1: SS34; D_SMA
D2: RED; LED_0805_2012Metric
J1: BAT; PinHeader_1x02_P2.54mm_Vertical
J2: M1; PinHeader_1x03_P2.54mm_Vertical
J3: M2; PinHeader_1x03_P2.54mm_Vertical
J4: SWD; PinHeader_1x04_P2.54mm_Vertical
J5: USB; PinHeader_1x04_P2.54mm_Vertical
L1: 4.7uH; L_Bourns-SRN6045
R1, R12, R13: 100k; R_0805_2012Metric
R2: 40.2k; R_0805_2012Metric
R3: 5.49k; R_0805_2012Metric
R4, R5, R6, R7: 4.7k; R_0805_2012Metric
R8: 120; R_0805_2012Metric
R9, R10: 10k; R_0805_2012Metric
R11: 1k; R_0805_2012Metric
SW1: SW; SW_SPST_PTS645
U1: STM32F103C8T6; LQFP-48_7x7mm_P0.5mm
U2, U3: L6234; PowerSO-20_11.1x15.9mm_P1.27mm
U4, U5: AS5600; SOIC-8_3.9x4.9mm_P1.27mm
U6: MPU6050; QFN-24-1EP_4x4mm_P0.5mm
U7: MP2225; TSOT-23-8
U8: AMS1117-3.3; SOT-223-3_TabPin2
U9: TJA1051T; SOIC-8_3.9x4.9mm_P1.27mm
U10: CH340C; SOIC-16_3.9x9.9mm_P1.27mm

Connections:
+3V3: C11.1, C12.1, C25.1, J4.4, R2.2, R4.2, R5.2, R6.2, R7.2, R10.2, R11.1, U1.1 (VBAT), U1.9 (VDDA), U1.24 (VDD), U1.36 (VDD), U1.48 (VDD), U4.1 (VDD5V), U4.2 (VDD3V3), U5.1 (VDD5V), U5.2 (VDD3V3), U6.8 (VLOGIC), U6.13 (VDD), U8.2 (VO)
+5V: C3.1, C4.1, J5.1, L1.2, U8.3 (VI), U9.3 (VCC), U10.16 (VCC)
BAT_DIV: R12.1, R13.1, U1.10 (PA0)
BOOT0: R9.1, U1.44 (BOOT0)
BST: C24.1, U7.5 (BST)
CAN_H: R8.1, U9.7 (CANH)
CAN_L: R8.2, U9.6 (CANL)
CAN_RX: U1.32 (PA11), U9.4 (RXD)
CAN_TX: U1.33 (PA12), U9.1 (TXD)
CH340_V3: C22.1, U10.4 (V3)
FB: R2.1, R3.1, U7.8 (FB)
GND: C1.2, C2.2, C3.2, C4.2, C5.2, C6.2, C11.2, C12.2, C13.2, C14.2, C15.2, C16.2, C17.2, C18.2, C19.2, C20.2, C21.2, C22.2, C23.2, C24.2, C25.2, D2.1 (K), J1.2, J4.3, J5.4, R3.2, R9.2, R13.2, U1.8 (VSSA), U1.23 (VSS), U1.35 (VSS), U1.47 (VSS), U2.1 (GND), U2.2 (SENSE1), U2.10 (GND), U2.11 (GND), U2.19 (SENSE2), U2.20 (GND), U3.1 (GND), U3.2 (SENSE1), U3.10 (GND), U3.11 (GND), U3.19 (SENSE2), U3.20 (GND), U4.4 (GND), U4.5 (PGO), U4.8 (DIR), U5.4 (GND), U5.5 (PGO), U5.8 (DIR), U6.1 (CLKIN), U6.9 (AD0), U6.11 (FSYNC), U6.18 (GND), U6.19 (RESV), U6.21 (RESV), U6.22 (RESV), U7.1 (AGND), U7.4 (GND), U8.1 (GND), U9.2 (GND), U9.8 (S), U10.1 (GND)
I2C1_SCL: R4.1, U1.42 (PB6), U4.7 (SCL)
I2C1_SDA: R5.1, U1.43 (PB7), U4.6 (SDA)
I2C2_SCL: R6.1, U1.21 (PB10), U5.7 (SCL), U6.23 (SCL)
I2C2_SDA: R7.1, U1.22 (PB11), U5.6 (SDA), U6.24 (SDA)
LED_A: D2.2 (A), R11.2
M1_EN: U1.19 (PB1), U2.3 (EN2), U2.8 (EN1), U2.13 (EN3)
M1_OUT1: J2.1, U2.6 (OUT1)
M1_OUT2: J2.2, U2.5 (OUT2)
M1_OUT3: J2.3, U2.15 (OUT3)
M1_PHA: U1.29 (PA8), U2.7 (IN1)
M1_PHB: U1.30 (PA9), U2.4 (IN2)
M1_PHC: U1.31 (PA10), U2.14 (IN3)
M2_EN: U1.25 (PB12), U3.3 (EN2), U3.8 (EN1), U3.13 (EN3)
M2_OUT1: J3.1, U3.6 (OUT1)
M2_OUT2: J3.2, U3.5 (OUT2)
M2_OUT3: J3.3, U3.15 (OUT3)
M2_PHA: U1.16 (PA6), U3.7 (IN1)
M2_PHB: U1.17 (PA7), U3.4 (IN2)
M2_PHC: U1.18 (PB0), U3.14 (IN3)
MPU_CP: C20.1, U6.20 (CPOUT)
MPU_RE: C21.1, U6.10 (REGOUT)
MP_EN: R1.2, U7.6 (EN)
MP_VB1: C14.1, U2.18 (Vboot)
MP_VB2: C17.1, U3.18 (Vboot)
MP_VCC: C23.1, U7.7 (VCC)
MP_VCP1: C13.1, U2.17 (Vcp)
MP_VCP2: C16.1, U3.17 (Vcp)
MP_VR1: C15.1, U2.16 (Vref)
MP_VR2: C18.1, U3.16 (Vref)
NRST: C19.1, R10.1, U1.7 (NRST)
SWCLK: J4.2, U1.37 (PA14)
SWDIO: J4.1, U1.34 (PA13)
SW_NODE: L1.1, U7.3 (SW)
SW_OUT: D1.2 (A), SW1.2 (B)
UART2_RX: U1.13 (PA3), U10.2 (TXD)
UART2_TX: U1.12 (PA2), U10.3 (RXD)
USB_DM: J5.2, U10.6 (UD-)
USB_DP: J5.3, U10.5 (UD+)
VIN: C1.1, C2.1, C5.1, C6.1, D1.1 (K), J1.1, R1.1, R12.2, SW1.1 (A), U2.9 (Vs), U2.12 (Vs), U3.9 (Vs), U3.12 (Vs), U7.2 (IN)
