baijiazheng/JB-Micro-Wheeled_leg-Robot/hardware/main_board_f407/main_f407.kicad_sch

## KiCad design hardware/main_board_f407/main_f407.kicad_sch (2026-09-13)

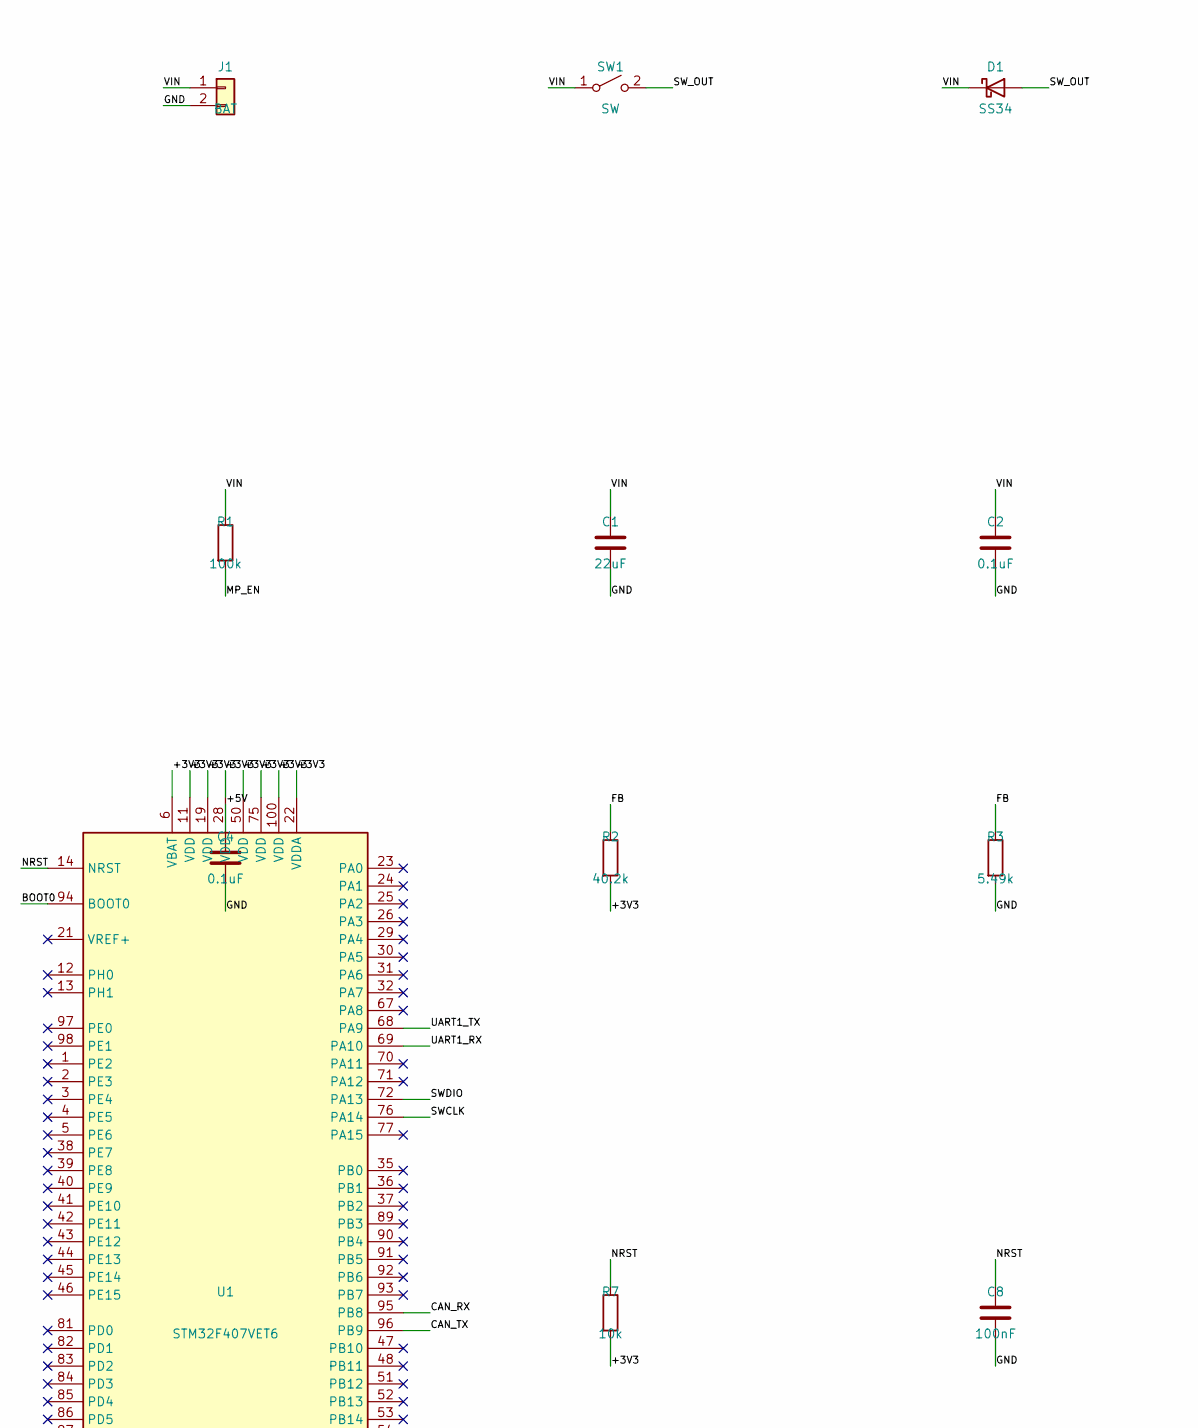
[picture p5: schematic main_f407.kicad_sch, part in row 1, column 1]

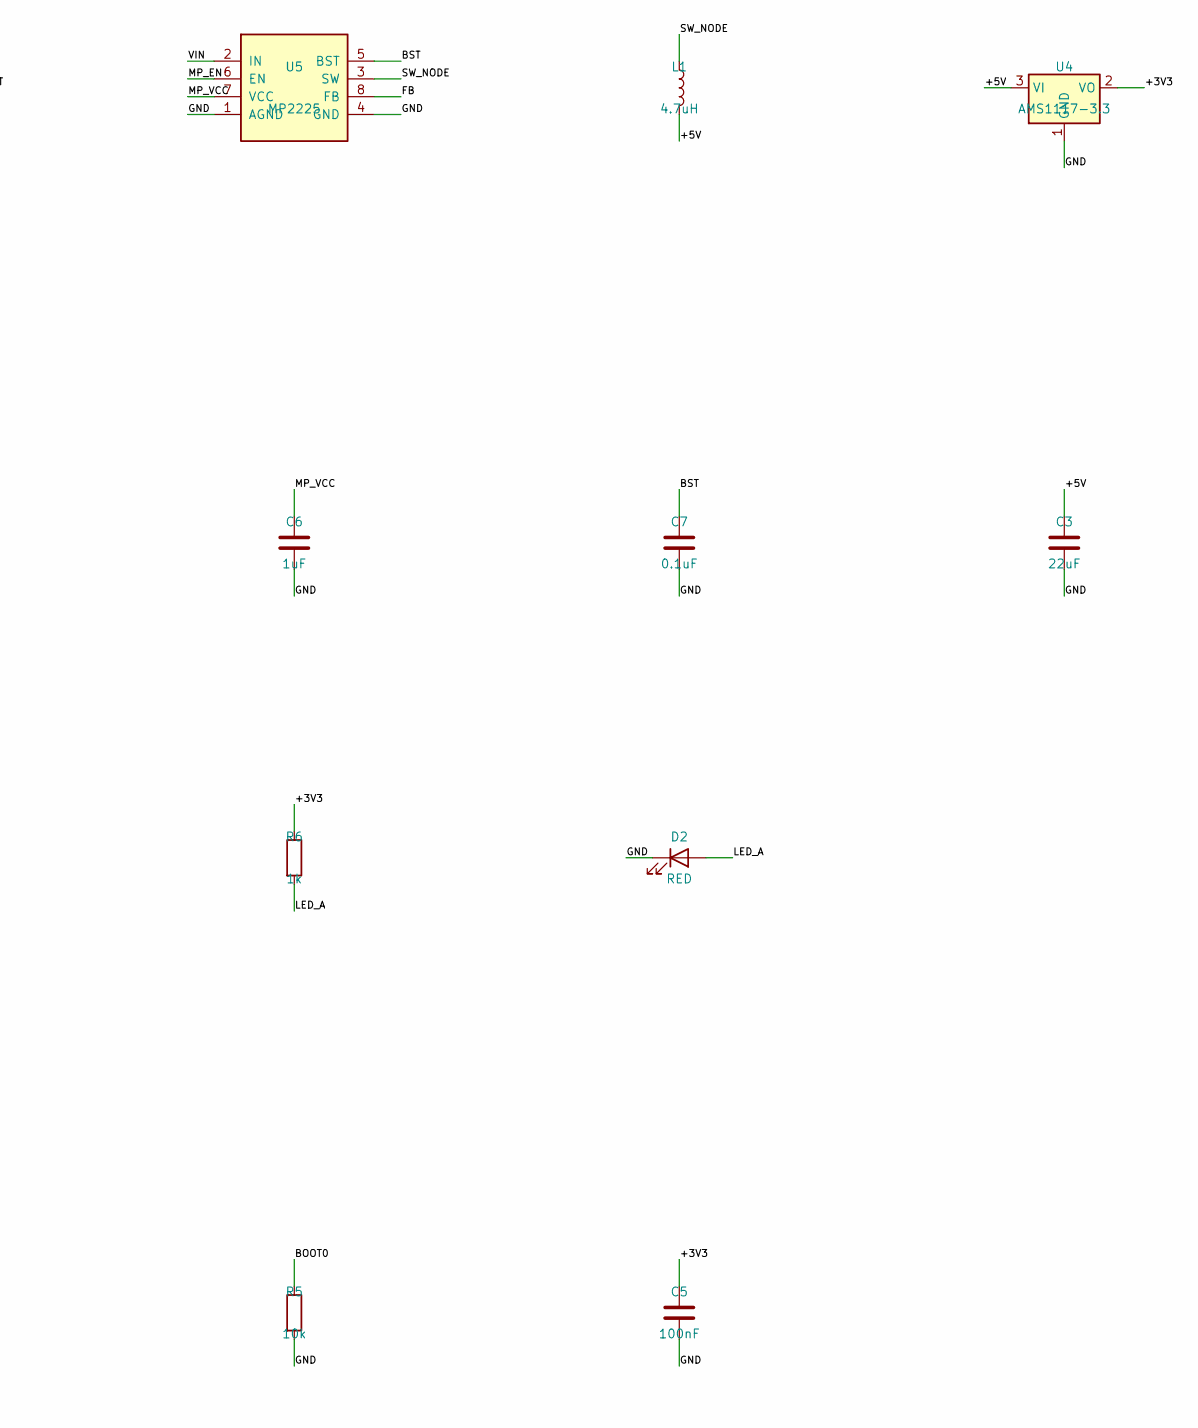
[picture p6: schematic main_f407.kicad_sch, part in row 1, column 2]

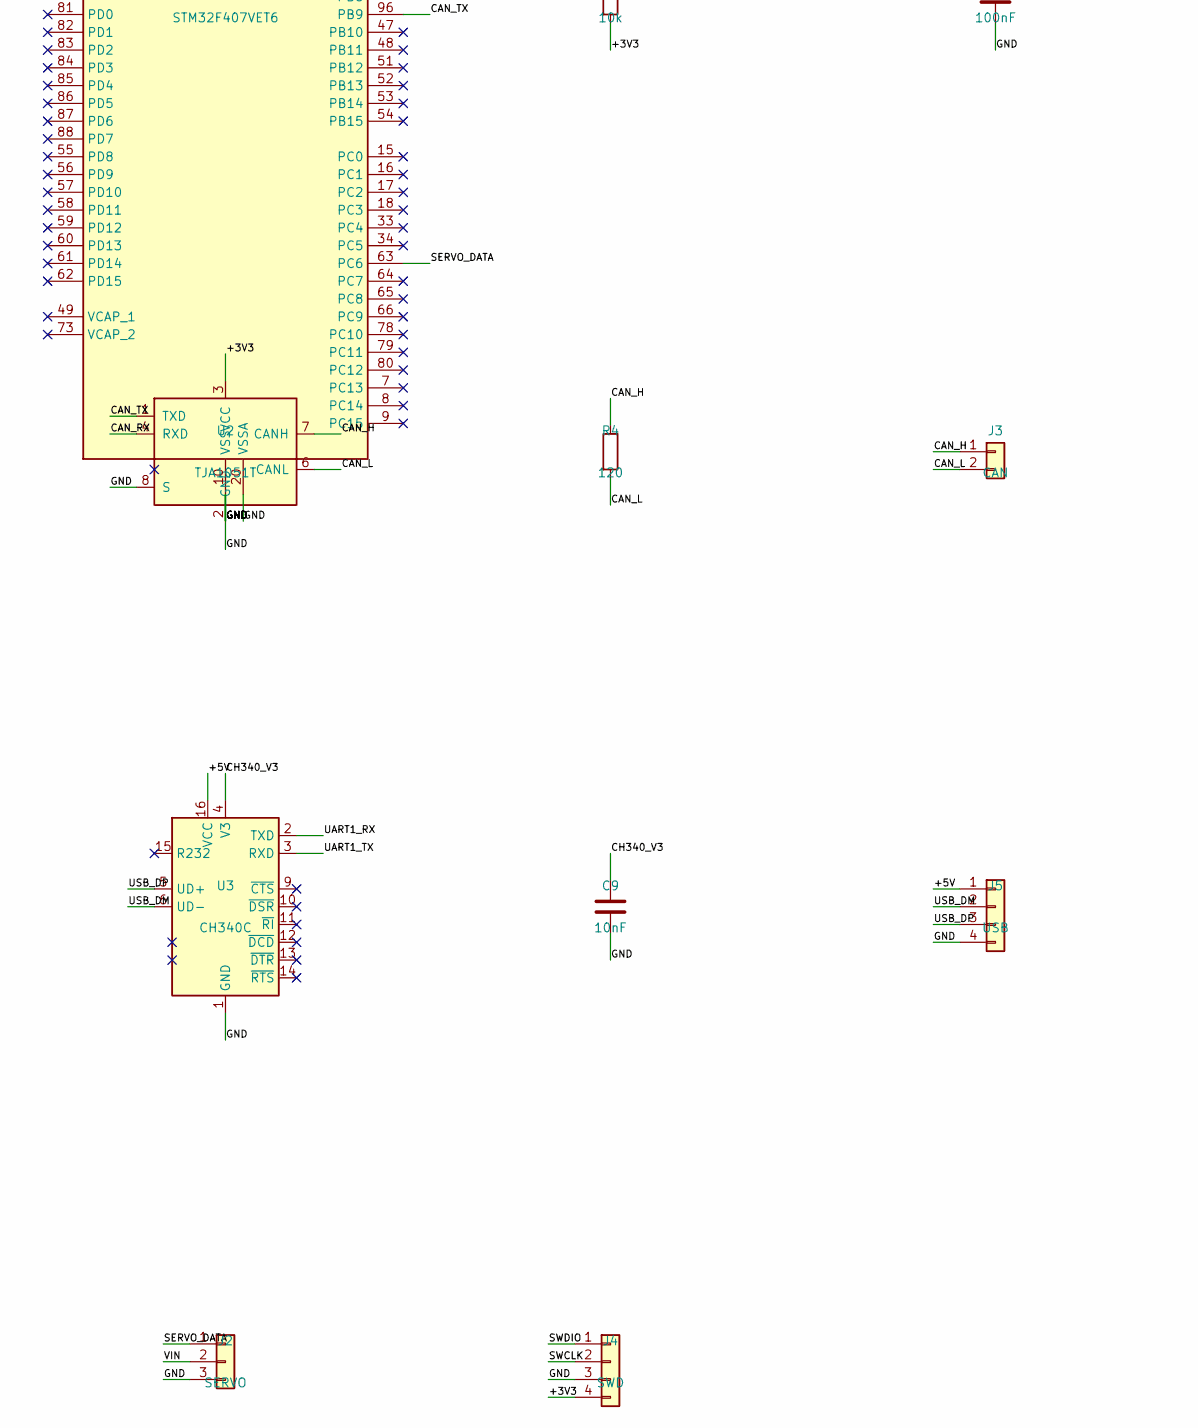
[picture p7: schematic main_f407.kicad_sch, part in row 2, column 1]

Parts:
C1, C3: 22uF; C_0805_2012Metric
C2, C4, C7: 0.1uF; C_0805_2012Metric
C5, C8: 100nF; C_0805_2012Metric
C6: 1uF; C_0805_2012Metric
C9: 10nF; C_0805_2012Metric
D1: SS34; D_SMA
D2: RED; LED_0805_2012Metric
J1: BAT; PinHeader_1x02_P2.54mm_Vertical
J2: SERVO; PinHeader_1x03_P2.54mm_Vertical
J3: CAN; PinHeader_1x02_P2.54mm_Vertical
J4: SWD; PinHeader_1x04_P2.54mm_Vertical
J5: USB; PinHeader_1x04_P2.54mm_Vertical
L1: 4.7uH; L_Bourns-SRN6045
R1: 100k; R_0805_2012Metric
R2: 40.2k; R_0805_2012Metric
R3: 5.49k; R_0805_2012Metric
R4: 120; R_0805_2012Metric
R5, R7: 10k; R_0805_2012Metric
R6: 1k; R_0805_2012Metric
SW1: SW; SW_SPST_PTS645
U1: STM32F407VET6; LQFP-100_14x14mm_P0.5mm
U2: TJA1051T; SOIC-8_3.9x4.9mm_P1.27mm
U3: CH340C; SOIC-16_3.9x9.9mm_P1.27mm
U4: AMS1117-3.3; SOT-223-3_TabPin2
U5: MP2225; TSOT-23-8

Connections:
+3V3: C5.1, J4.4, R2.2, R6.1, R7.2, U1.6 (VBAT), U1.11 (VDD), U1.19 (VDD), U1.22 (VDDA), U1.28 (VDD), U1.50 (VDD), U1.75 (VDD), U1.100 (VDD), U2.3 (VCC), U4.2 (VO)
+5V: C3.1, C4.1, J5.1, L1.2, U3.16 (VCC), U4.3 (VI)
BOOT0: R5.1, U1.94 (BOOT0)
BST: C7.1, U5.5 (BST)
CAN_H: J3.1, R4.1, U2.7 (CANH)
CAN_L: J3.2, R4.2, U2.6 (CANL)
CAN_RX: U1.95 (PB8), U2.4 (RXD)
CAN_TX: U1.96 (PB9), U2.1 (TXD)
CH340_V3: C9.1, U3.4 (V3)
FB: R2.1, R3.1, U5.8 (FB)
GND: C1.2, C2.2, C3.2, C4.2, C5.2, C6.2, C7.2, C8.2, C9.2, D2.1 (K), J1.2, J2.3, J4.3, J5.4, R3.2, R5.2, U1.10 (VSS), U1.20 (VSSA), U1.27 (VSS), U1.74 (VSS), U1.99 (VSS), U2.2 (GND), U2.8 (S), U3.1 (GND), U4.1 (GND), U5.1 (AGND), U5.4 (GND)
LED_A: D2.2 (A), R6.2
MP_EN: R1.2, U5.6 (EN)
MP_VCC: C6.1, U5.7 (VCC)
NRST: C8.1, R7.1, U1.14 (NRST)
SERVO_DATA: J2.1, U1.63 (PC6)
SWCLK: J4.2, U1.76 (PA14)
SWDIO: J4.1, U1.72 (PA13)
SW_NODE: L1.1, U5.3 (SW)
SW_OUT: D1.2 (A), SW1.2 (B)
UART1_RX: U1.69 (PA10), U3.2 (TXD)
UART1_TX: U1.68 (PA9), U3.3 (RXD)
USB_DM: J5.2, U3.6 (UD-)
USB_DP: J5.3, U3.5 (UD+)
VIN: C1.1, C2.1, D1.1 (K), J1.1, J2.2, R1.1, SW1.1 (A), U5.2 (IN)
