baijiazheng/JB-Micro-Wheeled_leg-Robot/(commit log)

2026-09-13 Add firmware files and netlist script for driver board F103
    - Added main_f407.elf and main_f407.map firmware files.
    - Introduced netlist.py script for defining and validating the netlist of the driver board F103, including components and connections.
2026-09-13 feat: add netlist definition and validation for main board F407
    - Introduced a new Python script `netlist.py` for defining and validating the netlist of the main control board F407.
    - Defined components with their specifications and connections in the `COMPONENTS` list.
    - Established net connections in the `NETS` dictionary, covering power, CAN bus, servo data, USB debugging, and SWD.
    - Implemented a validation function to check for duplicate pins and required nets, ensuring the integrity of the netlist.
    - Added a main execution block to run validation and output results.
2026-09-13 Refactor code structure for improved readability and maintainability
    [driver_f103.kicad_sch, main_f407.kicad_sch, templates.json]
2026-09-13 feat: add project handoff and board specification documentation
2026-09-14 Add IMU board schematic for JB-Micro-Wheeled-leg-Robot (MPU6050)
    - Created a new JSON file for the IMU board schematic.
    - Included details such as component libraries, connections, and annotations.
    - Defined the layout and properties of the MPU6050 sensor and associated components.
